RodionSmilovskyi/drone-control-center/printed_parts/TOF400C .jpg

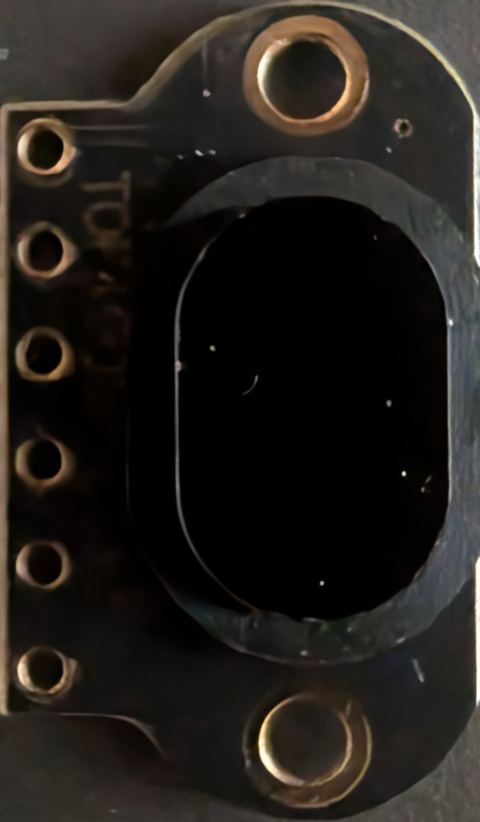
printed_parts/TOF400C .jpg
