RodionSmilovskyi/drone-control-center/printed_parts/PMW3901.jpg

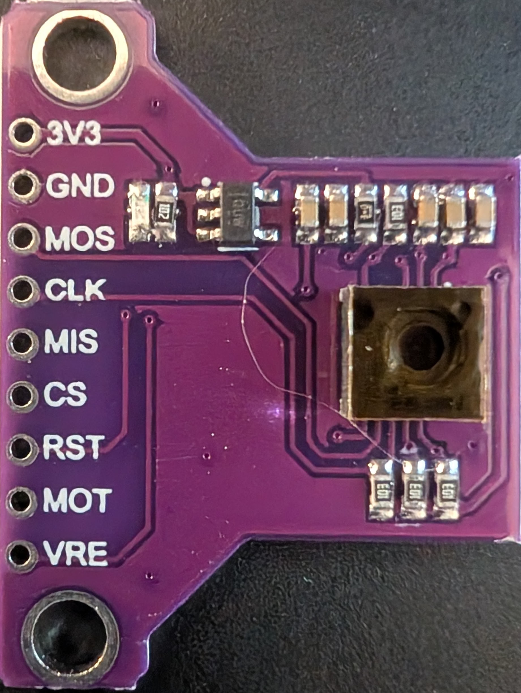
printed_parts/PMW3901.jpg
