RodionSmilovskyi/drone-control-center/README.md

# Useful commands
ssh rodion@10.0.0.131  
scp server.py  rodion@10.0.0.131:~/drone  

# Sample GUI output
Press 'q' to quit, 'r' to reboot, 'm' to change mode, 'a' to arm, 'd' to disarm and arrow keys to control  

ARMED: False                                      armingDisableFlags: []
cpuload: 23                                       cycleTime: 248
mode: 0                                           Flight Mode: []
Battery Voltage: 16.02V VOLTAGE TOO HIGH
Motor Values: [1000, 1000, 1000, 1000, 0, 0, 0, 0]
Attitude: [-1.3, -1.3, 73]
Altitude: 3.04
RC Channels Values: [1500, 1500, 1500, 900, 1000, 1000, 1500, 1500, 1500, 1500, 1500, 1500, 1500, 1500, 1500, 1500, 1500GUI cycleTime: 15.99ms (average 62.54Hz)]

apiVersion: 1.46.0                                flightControllerIdentifier: BTFL
flightControllerVersion: 4.5.2                    boardIdentifier: S405
boardName: SPEEDYBEEF405MINI                      name:
