RodionSmilovskyi/drone-control-center/requirements-pi.txt

#
# This file is autogenerated by pip-compile with Python 3.11
# by the following command:
#
#    pip-compile --extra=pi --output-file=requirements-pi.txt
#
adafruit-blinka==8.67.0
    # via
    #   adafruit-circuitpython-busdevice
    #   adafruit-circuitpython-connectionmanager
    #   adafruit-circuitpython-requests
    #   adafruit-circuitpython-typing
    #   adafruit-circuitpython-vl53l1x
    #   drone-control-center (pyproject.toml)
adafruit-circuitpython-busdevice==5.2.16
    # via
    #   adafruit-circuitpython-typing
    #   adafruit-circuitpython-vl53l1x
adafruit-circuitpython-connectionmanager==3.1.7
    # via adafruit-circuitpython-requests
adafruit-circuitpython-requests==4.1.16
    # via adafruit-circuitpython-typing
adafruit-circuitpython-typing==1.12.3
    # via
    #   adafruit-blinka
    #   adafruit-circuitpython-busdevice
adafruit-circuitpython-vl53l1x==1.2.7
    # via drone-control-center (pyproject.toml)
adafruit-platformdetect==3.88.0
    # via adafruit-blinka
adafruit-pureio==1.1.11
    # via adafruit-blinka
binho-host-adapter==0.1.6
    # via adafruit-blinka
gpiod==2.4.2
    # via
    #   drone-control-center (pyproject.toml)
    #   gpiodevice
gpiodevice==0.0.5
    # via drone-control-center (pyproject.toml)
markdown-it-py==4.0.0
    # via rich
mdurl==0.1.2
    # via markdown-it-py
numpy==1.23.5
    # via
    #   drone-control-center (pyproject.toml)
    #   tflite-runtime
pmw3901==1.0.0
    # via drone-control-center (pyproject.toml)
pyftdi==0.57.1
    # via adafruit-blinka
pygments==2.20.0
    # via rich
pyserial==3.5
    # via
    #   binho-host-adapter
    #   drone-control-center (pyproject.toml)
    #   pyftdi
    #   yamspy
pyusb==1.3.1
    # via pyftdi
pyzmq==27.1.0
    # via drone-control-center (pyproject.toml)
rich==15.0.0
    # via drone-control-center (pyproject.toml)
spidev==3.8
    # via
    #   drone-control-center (pyproject.toml)
    #   pmw3901
sysv-ipc==1.2.0
    # via adafruit-blinka
tflite-runtime==2.14.0
    # via drone-control-center (pyproject.toml)
typing-extensions==4.15.0
    # via adafruit-circuitpython-typing
yamspy==0.3.3
    # via drone-control-center (pyproject.toml)
