RodionSmilovskyi/drone-control-center/docs/data_injection_pipeline.png

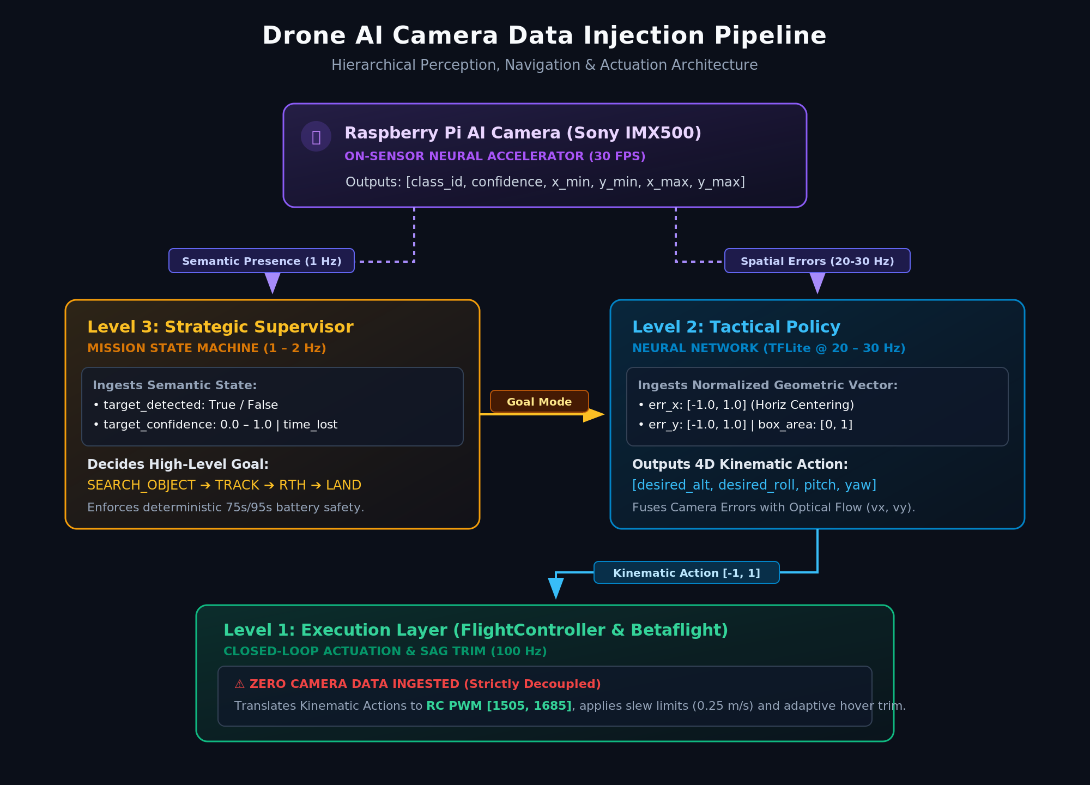
docs/data_injection_pipeline.png
