RodionSmilovskyi/drone-control-center/printed_parts/assembly-BottomStand3.stl

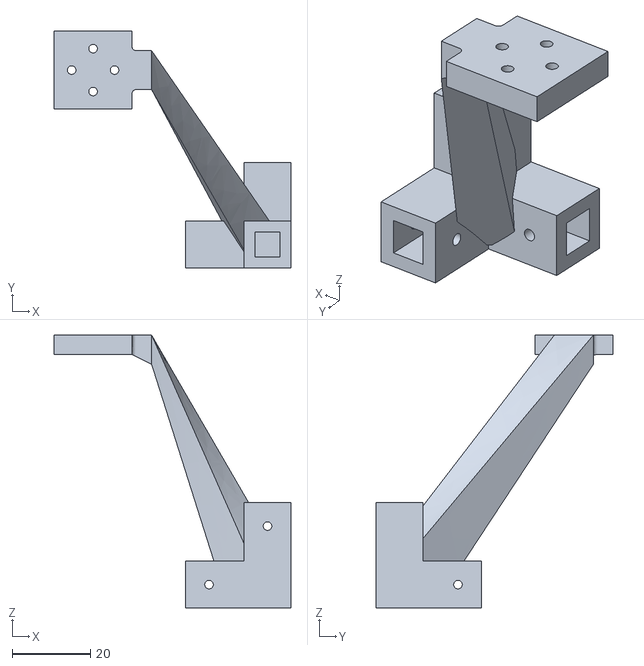
[picture p4: CAD file, 2026-09-27]
printed_parts/assembly-BottomStand3.stl
60.7 x 60.7 x 70.0
