RodionSmilovskyi/drone-control-center/printed_parts/assembly.FCStd

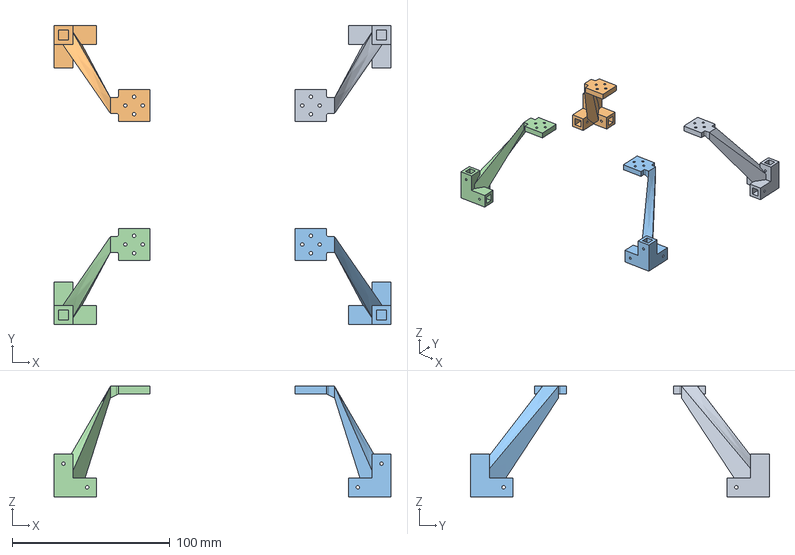
[picture p5: CAD file, 2026-09-27]
printed_parts/assembly.FCStd
213.4 x 189.4 x 70.0 mm
FrontBottomLeftStand
BottomStand (Mirror #1)
BottomStand (Mirror #3)
BottomStand (Mirror #5)
