RodionSmilovskyi/drone-control-center/printed_parts/assembly-HorizontaRod_short.stl

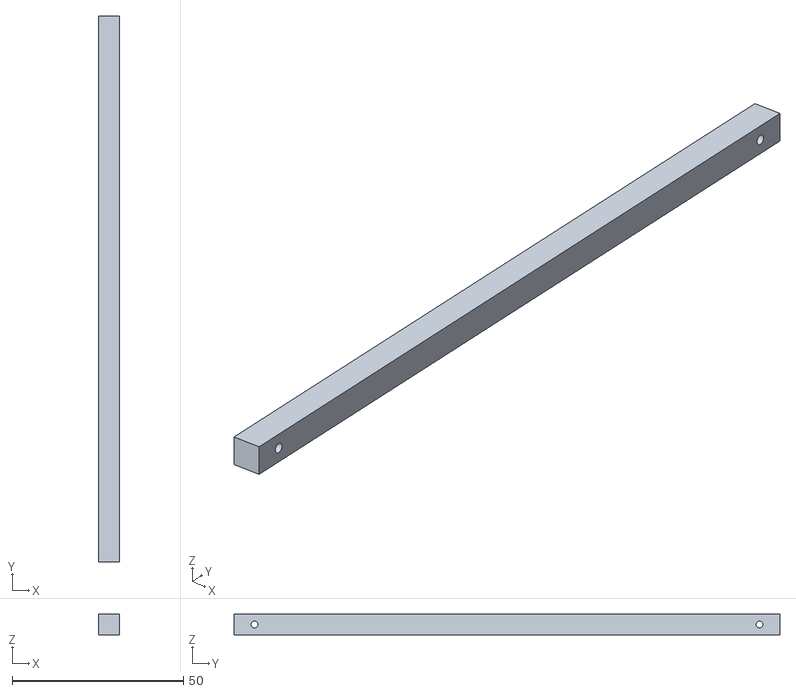
[picture p6: CAD file, 2026-02-09]
printed_parts/assembly-HorizontaRod_short.stl
6.00 x 159.4 x 6.00
