RodionSmilovskyi/drone-control-center/printed_parts/assembly-HorizontalRod_long.stl

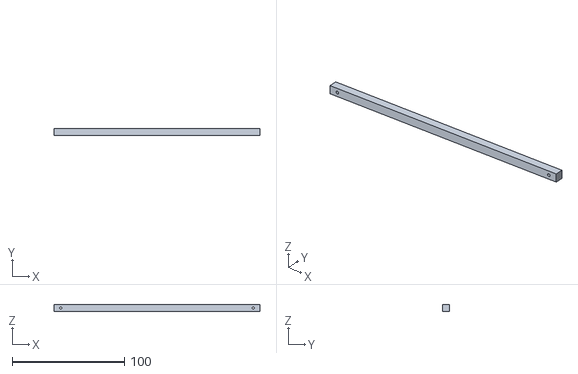
[picture p7: CAD file, 2026-02-09]
printed_parts/assembly-HorizontalRod_long.stl
183.4 x 6.00 x 6.00
