RodionSmilovskyi/drone-control-center/printed_parts/assembly-TopStand.stl

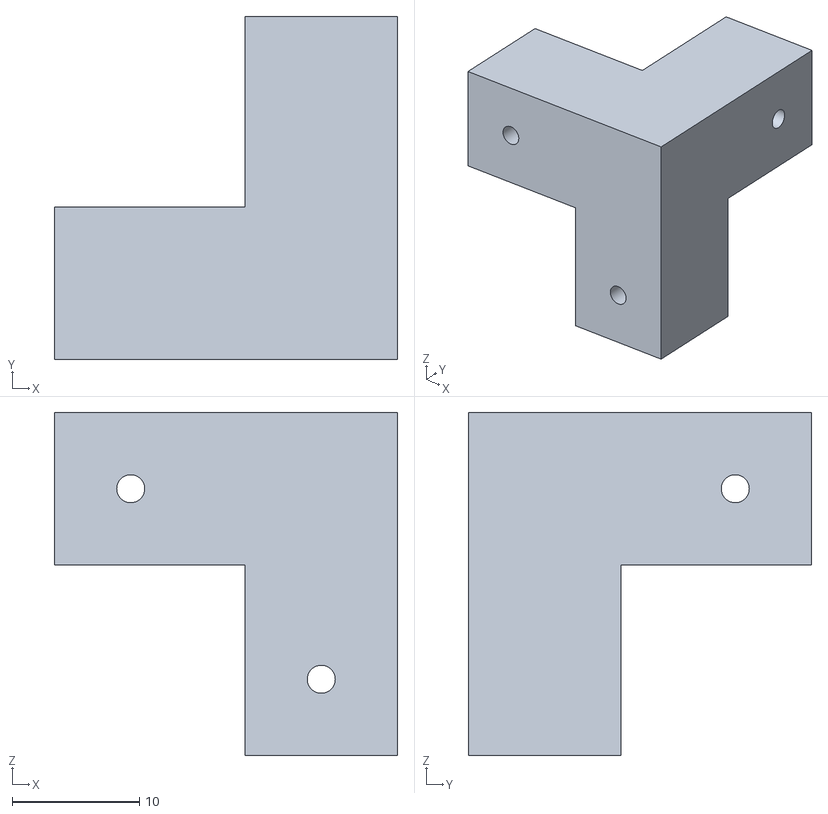
[picture p8: CAD file, 2026-02-08]
printed_parts/assembly-TopStand.stl
27.0 x 27.0 x 27.0
