RodionSmilovskyi/drone-control-center/printed_parts/assembly-VerticalRod.stl

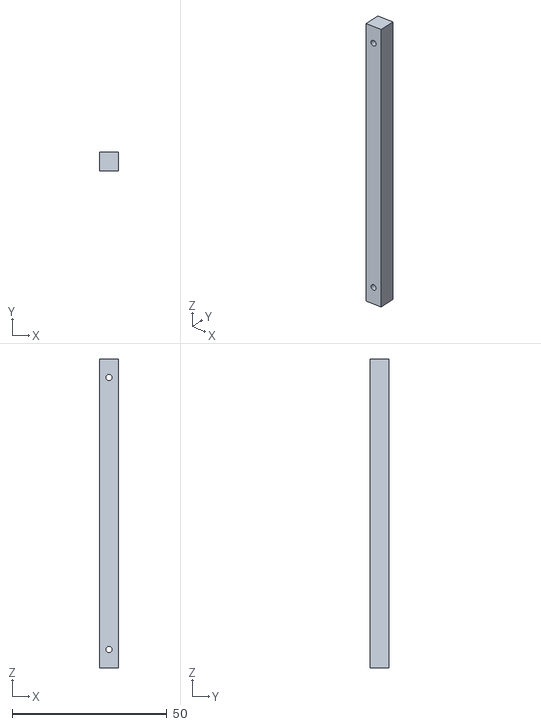
[picture p9: CAD file, 2026-02-08]
printed_parts/assembly-VerticalRod.stl
6.00 x 6.00 x 100.0
