RodionSmilovskyi/drone-control-center/printed_parts/2_Pin.STL

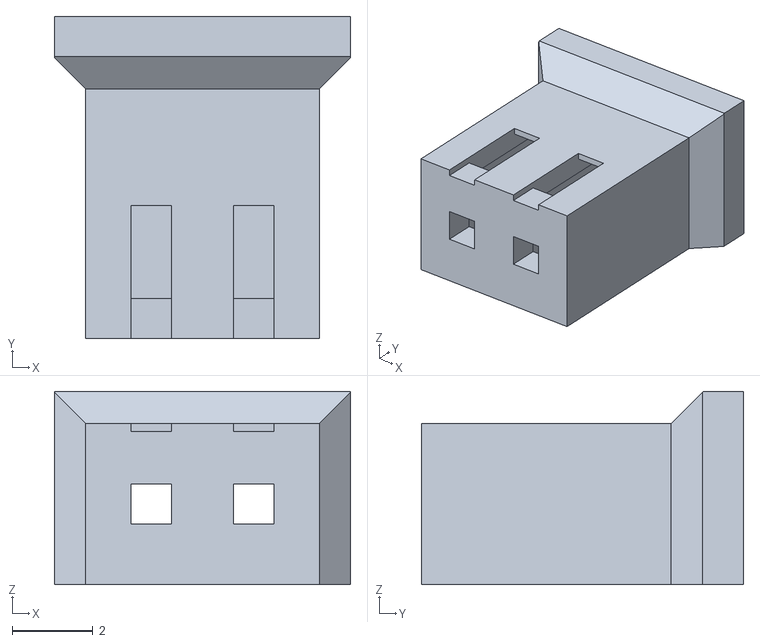
[picture p10: CAD file, 2026-09-27]
printed_parts/2_Pin.STL
7.35 x 8.00 x 4.80
