RodionSmilovskyi/drone-control-center/printed_parts/enclosure.FCStd

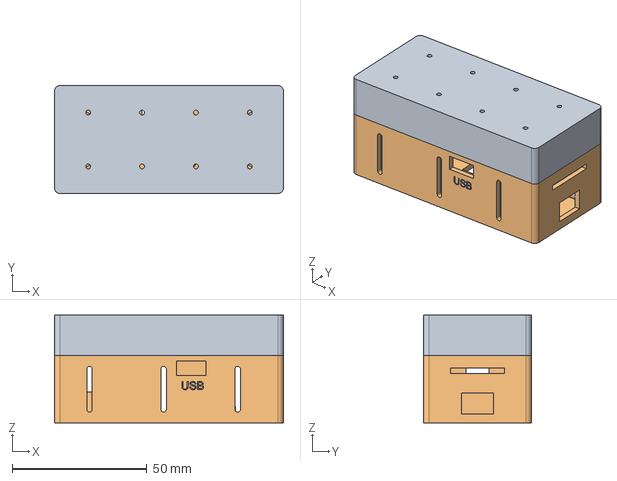
[picture p11: CAD file, 2026-09-27]
printed_parts/enclosure.FCStd
85.0 x 40.0 x 40.0 mm
top lid
bottom lid
