RodionSmilovskyi/drone-control-center/printed_parts/xh-2y.FCStd

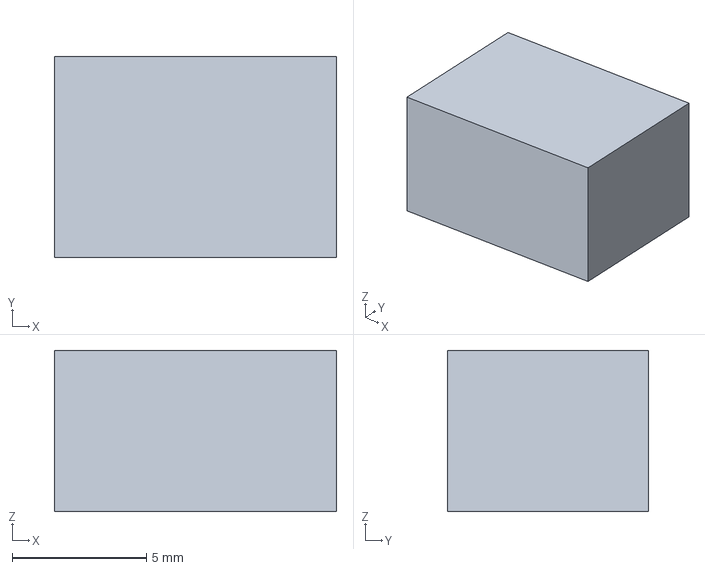
[picture p12: CAD file, 2026-09-27]
printed_parts/xh-2y.FCStd
10.5 x 7.50 x 6.00 mm
