RodionSmilovskyi/drone-control-center/printed_parts/Raspberry Pi Zero 2 W with Textures.stp

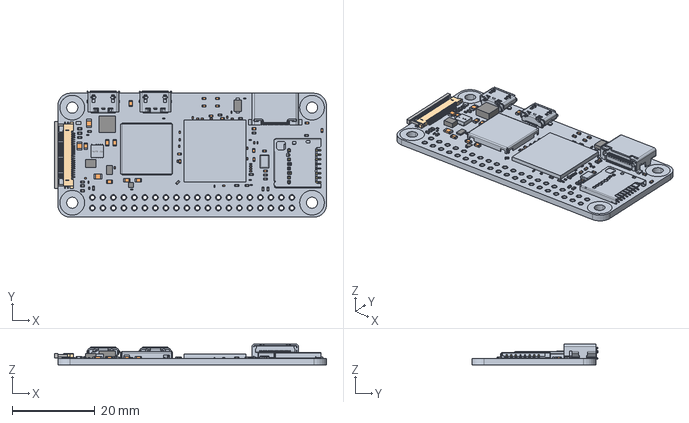
[picture p13: CAD file, 2026-09-27]
printed_parts/Raspberry Pi Zero 2 W with Textures.stp
65.8 x 30.6 x 5.05 mm
