RodionSmilovskyi/drone-control-center/printed_parts/TOF400C.FCStd

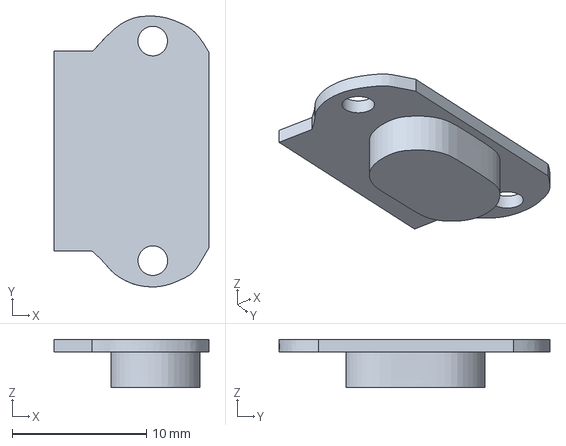
[picture p14: CAD file, 2026-09-27]
printed_parts/TOF400C.FCStd
11.5 x 20.1 x 3.58 mm
