RodionSmilovskyi/drone-control-center/printed_parts/PMW3901.FCStd

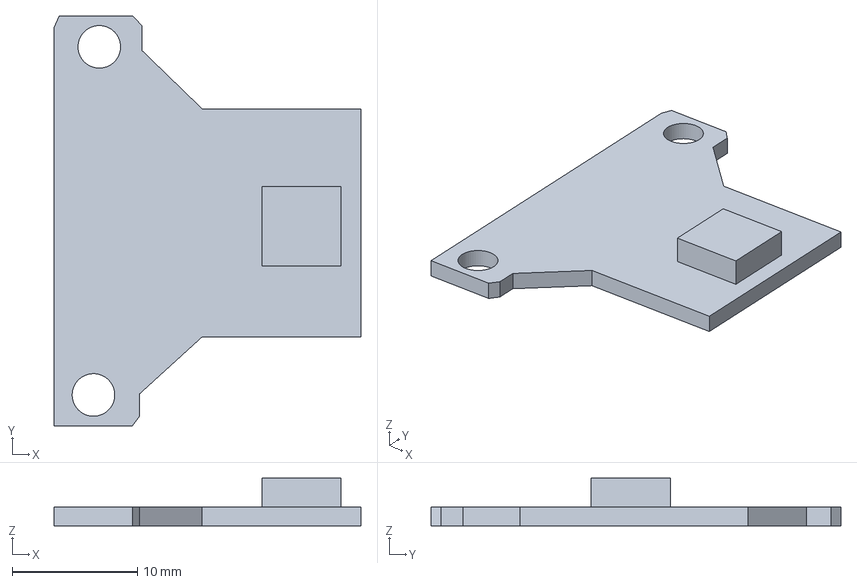
[picture p15: CAD file, 2026-09-27]
printed_parts/PMW3901.FCStd
24.5 x 32.8 x 3.80 mm
