RodionSmilovskyi/drone-control-center/printed_parts/enclosure-top lid.stl

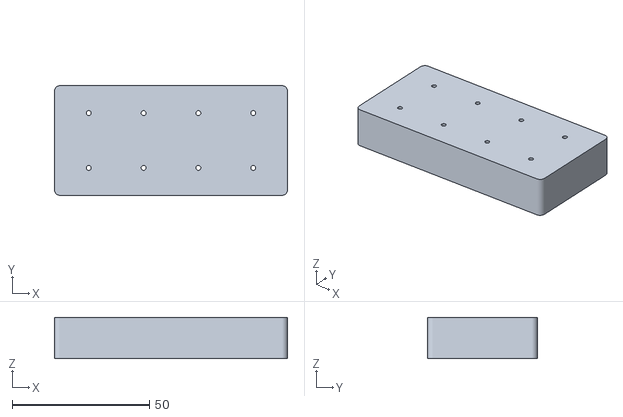
[picture p16: CAD file, 2026-09-27]
printed_parts/enclosure-top lid.stl
85.0 x 40.0 x 15.0
