RodionSmilovskyi/drone-control-center/printed_parts/raspberry-pi.FCStd

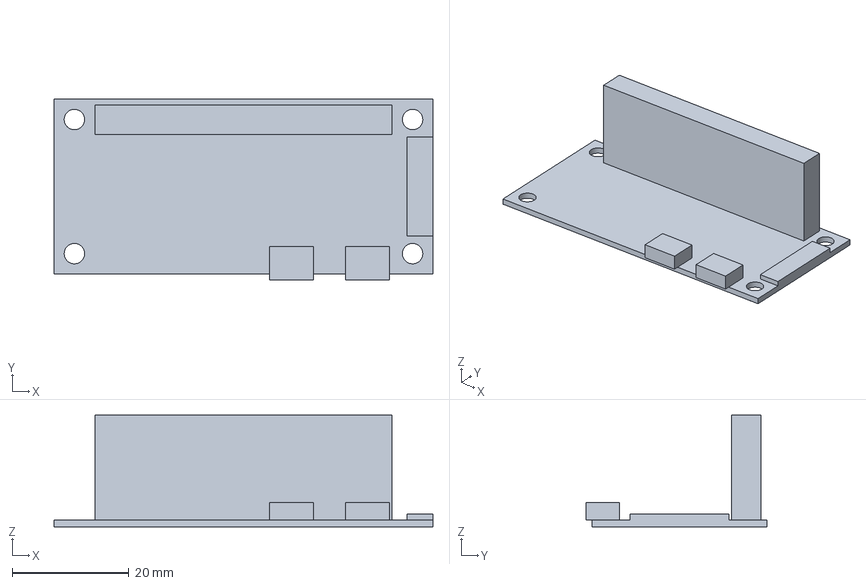
[picture p17: CAD file, 2026-09-27]
printed_parts/raspberry-pi.FCStd
65.0 x 31.0 x 19.2 mm
