RodionSmilovskyi/drone-control-center/printed_parts/raspberry-pi-PartBody.dxf

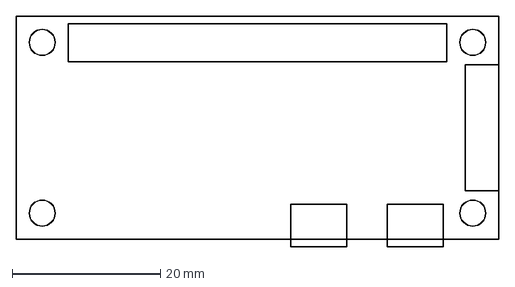
[picture p18: CAD file, 2026-09-27]
printed_parts/raspberry-pi-PartBody.dxf
65.0 x 31.0 mm
