RodionSmilovskyi/drone-control-center/printed_parts/enclosure-bottom lid.stl

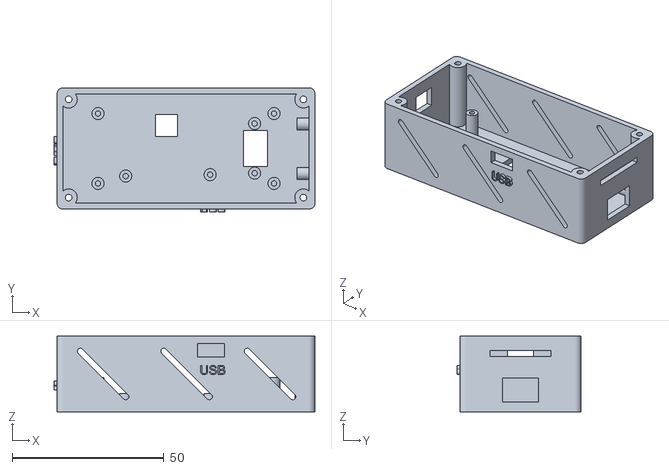
[picture p19: CAD file, 2026-09-27]
printed_parts/enclosure-bottom lid.stl
86.0 x 41.0 x 25.0
