RodionSmilovskyi/drone-control-center/printed_parts/front-sensor-holder.stl

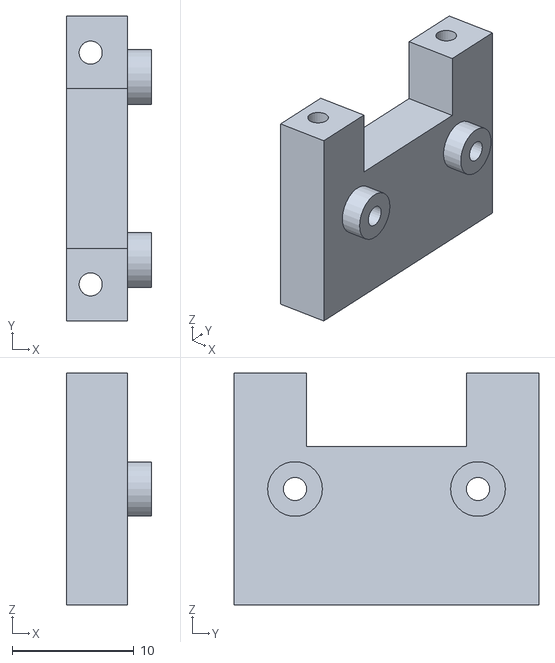
[picture p20: CAD file, 2026-02-08]
printed_parts/front-sensor-holder.stl
7.00 x 25.0 x 19.0
