RodionSmilovskyi/drone-control-center/printed_parts/bottom-sensor-holder.stl

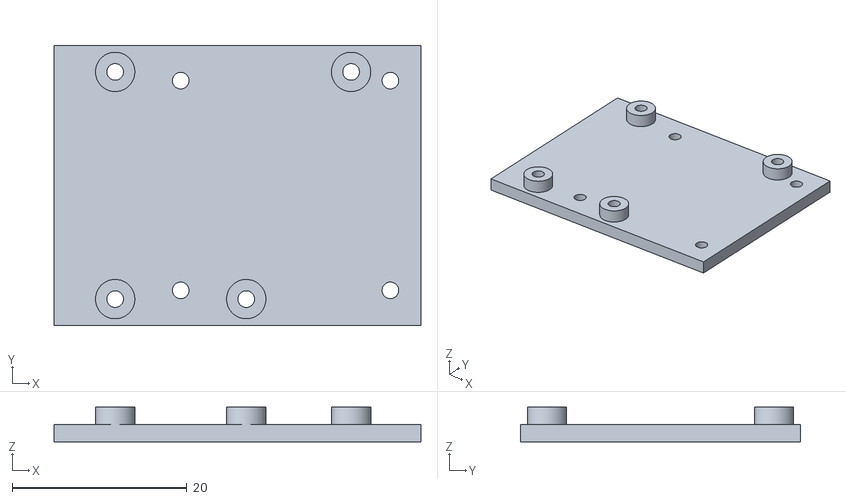
[picture p21: CAD file, 2026-02-08]
printed_parts/bottom-sensor-holder.stl
42.0 x 32.0 x 4.00
