RodionSmilovskyi/drone-control-center/(list of files, cad)

Other CAD files:
printed_parts/assembly-BottomStand2.stl
printed_parts/assembly-BottomStand4.stl
printed_parts/assembly-BottomStand1.stl
printed_parts/ai-case.FCStd
printed_parts/raspberry pi.stl
