RodionSmilovskyi/drone-control-center/custom_pcbs/breakout_board/breakout_board.kicad_pcb

## KiCad design custom_pcbs/breakout_board/breakout_board.kicad_pcb (2026-09-27)

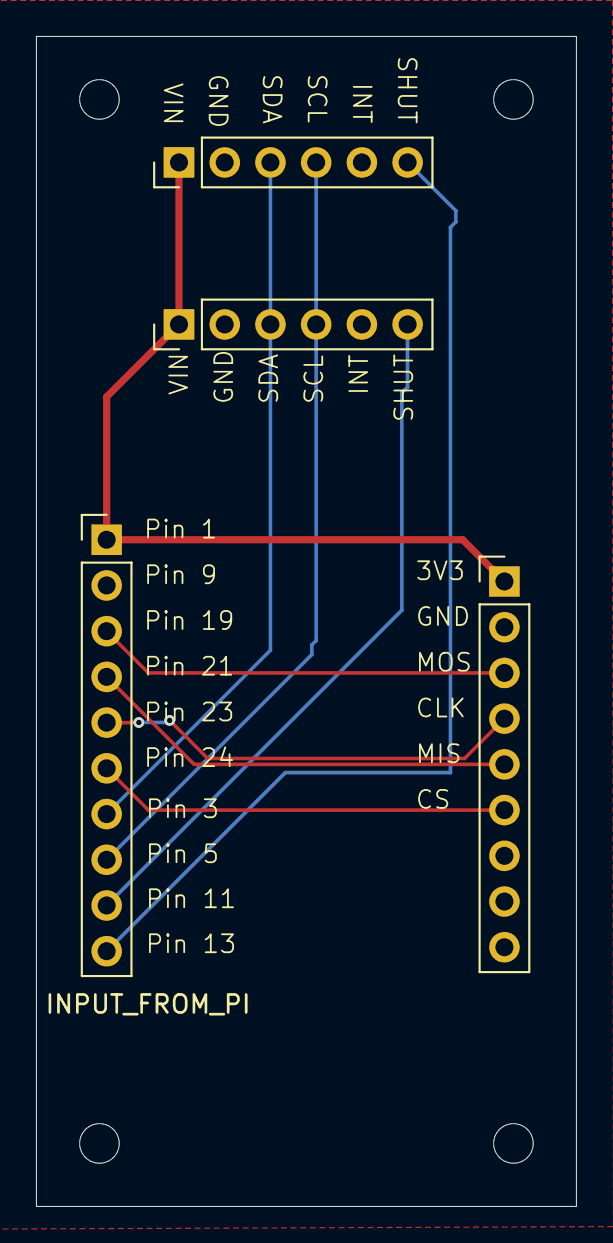
[picture p22: board breakout_board.kicad_pcb from above]

Board: 4 copper layers, 30.0 x 65.0 mm, 8 parts (0 on the bottom side), 10 nets.

Parts:
H1, H2, H3, H4: MountingHole; MountingHole_2.2mm_M2
J1: INPUT_FROM_PI; PinHeader_1x10_P2.54mm_Vertical
J2: PMW3901_OUT; PinHeader_1x09_P2.54mm_Vertical
VL53L1X_1_OUT, VL53L1X_2_OUT: Conn_01x06; PinHeader_1x06_P2.54mm_Vertical

Connections:
+3V3: J1.1, J2.1, VL53L1X_1_OUT.1, VL53L1X_2_OUT.1
/I2C_SCL: J1.8, VL53L1X_1_OUT.4, VL53L1X_2_OUT.4
/I2C_SDA: J1.7, VL53L1X_1_OUT.3, VL53L1X_2_OUT.3
/SPI_CLK: J1.5, J2.4
/SPI_CS: J1.6, J2.6
/SPI_MISO: J1.4, J2.5
/SPI_MOSI: J1.3, J2.3
/XSHUT_1: J1.9, VL53L1X_1_OUT.6
/XSHUT_2: J1.10, VL53L1X_2_OUT.6
GND: J1.2, J2.2, VL53L1X_1_OUT.2, VL53L1X_2_OUT.2
