RodionSmilovskyi/drone-control-center/services/drone-sensors/sensor_real.py

import time
import board
import digitalio
import adafruit_vl53l1x
import pmw3901
import logging
import sys
import os
import threading
import math

# Add project root to sys.path
sys.path.insert(0, os.path.abspath(os.path.join(os.path.dirname(__file__), '../..')))
from core.drone_logging import setup_logger

MAX_XY_SHIFT = 1.0

# --- Configuration ---
LOG_FILE = "sensor.log"

# --- Pin Definitions ---
DOWN_SENSOR_SHUT_PIN = board.D17
OBSTACLE_SENSOR_SHUT_PIN = board.D27
DOWN_SENSOR_ADDRESS = 0x30
FRONT_SENSOR_ADDRESS = 0x31
SPI_CS_PIN = 8 

class SensorReal:
    def __init__(self):
        self.logger = setup_logger("Sensor_Real", LOG_FILE, logging.INFO)
        self.sensor_down = None
        self.sensor_front = None
        self.flow = None
        
        # State variables
        self.altitude = 0.0
        self.front_dist = 0.0
        self.shift_x = 0.0
        self.shift_y = 0.0
        self.vel_x_norm = 0.0
        self.vel_y_norm = 0.0
        self.last_time = time.time()

        # Optical Flow Constants (PMW3901)
        self.FOV_DEGREES = 42.0
        self.RESOLUTION = 35.0
        # Calibrated value: 20cm move at ~13.7cm altitude resulted in 731 pixels.
        # Constant = 0.20 / (731 * 0.137) ≈ 0.001997
        self.FLOW_METERS_PER_PIXEL_PER_METER = 0.001997
        
        # Normalization and Calibration
        self.MAX_VELOCITY = 5.0
        self.MAX_XY_SHIFT = MAX_XY_SHIFT # From strategic_agent
        self.MAX_ALTITUDE = 3.0
        self.MAX_FRONT_DISTANCE = 3.0
        self.NOMINAL_FLOW_DT = 0.035      # Nominal ~28.5 Hz PMW3901 frame interval for multi-frame stall normalization
        self.MAX_FRAME_SHIFT_M = 0.030    # Max 3.0 cm single-frame displacement step to reject SPI/rotational spikes
        self.MAX_PHYSICAL_VEL_MS = 0.60   # Max 0.60 m/s physical indoor speed clamp before normalization
        
        # Deadbands and Smoothing
        self.FLOW_DEADBAND = 0.05 # Threshold on filtered value to suppress jitter
        self.ALPHA_FLOW = 0.42   # Balanced optical flow LPF (~45ms tau) to suppress SPI pixel steps while keeping low lag
        self.ALPHA_ALT = 0.6     # Lower phase lag for altitude feedback
        self.ALPHA_FRONT = 0.3
        self.ALPHA_VEL = 0.45    # Balanced velocity LPF (~40ms tau) to prevent single-frame D-term kicks in inner loop
        self.GROUND_ALT_THRESHOLD = 0.045  # Above resting/spin-up ground height (~0.028-0.043m)

        self.filtered_dx = 0.0
        self.filtered_dy = 0.0

        self.lock = threading.Lock()
        self._init_hardware()
        
        # Start dedicated background polling threads for I2C (ToF) and SPI (Optical Flow)
        # so that blocking SPI motion waits never stall altitude ToF updates, and SPI burst
        # reads are never prematurely aborted before frame completion.
        self.stop_thread = False
        self.tof_thread = threading.Thread(target=self._poll_tof_loop, daemon=True)
        self.flow_thread = threading.Thread(target=self._poll_flow_loop, daemon=True)
        self.tof_thread.start()
        self.flow_thread.start()

    def _init_hardware(self):
        try:
            i2c = board.I2C()
            xshut_down = digitalio.DigitalInOut(DOWN_SENSOR_SHUT_PIN)
            xshut_down.direction = digitalio.Direction.OUTPUT

            xshut_front = digitalio.DigitalInOut(OBSTACLE_SENSOR_SHUT_PIN)
            xshut_front.direction = digitalio.Direction.OUTPUT
            
            # Shut down both sensors
            xshut_down.value = False
            xshut_front.value = False
            time.sleep(0.1)
            
            # Initialize Down Sensor
            try:
                xshut_down.value = True
                time.sleep(0.1)
                self.sensor_down = adafruit_vl53l1x.VL53L1X(i2c)
                self.sensor_down.set_address(DOWN_SENSOR_ADDRESS)
                self.sensor_down.start_ranging()
                self.logger.info("Down-Sensor initialized.")
            except Exception as e:
                self.logger.error(f"Failed to init Down-Sensor: {e}")

            # Initialize Front Sensor
            try:
                xshut_front.value = True
                time.sleep(0.1)
                self.sensor_front = adafruit_vl53l1x.VL53L1X(i2c)
                self.sensor_front.set_address(FRONT_SENSOR_ADDRESS)
                self.sensor_front.start_ranging()
                self.logger.info("Front-Sensor initialized.")
            except Exception as e:
                self.logger.error(f"Failed to init Front-Sensor: {e}")

            # Initialize Optical Flow
            try:
                self.flow = pmw3901.PMW3901(spi_cs_gpio=SPI_CS_PIN)
                self.flow.set_rotation(0)
                self.logger.info("Optical Flow initialized.")
            except Exception as e:
                self.logger.error(f"Failed to init Optical Flow: {e}")

        except Exception as e:
            self.logger.critical(f"Hardware Initialization Error: {e}")

    def _poll_tof_loop(self):
        """Dedicated I2C polling loop for downward (altitude) and forward ToF sensors."""
        while not self.stop_thread:
            with self.lock:
                new_alt = self.altitude
                new_front = self.front_dist

            # 1. Altitude Reading
            if self.sensor_down:
                try:
                    if self.sensor_down.data_ready:
                        raw_dist = self.sensor_down.distance 
                        if raw_dist is not None:
                            raw_alt_m = max(0.0, min(self.MAX_ALTITUDE, raw_dist / 100.0))
                            new_alt = (self.ALPHA_ALT * raw_alt_m) + ((1.0 - self.ALPHA_ALT) * new_alt)
                        self.sensor_down.clear_interrupt()
                except Exception:
                    pass

            # 2. Front Distance Reading
            if self.sensor_front:
                try:
                    if self.sensor_front.data_ready:
                        raw_front_dist = self.sensor_front.distance
                        if raw_front_dist is not None:
                            raw_front_m = max(0.0, min(self.MAX_FRONT_DISTANCE, raw_front_dist / 100.0))
                            new_front = (self.ALPHA_FRONT * raw_front_m) + ((1.0 - self.ALPHA_FRONT) * new_front)
                        self.sensor_front.clear_interrupt()
                except Exception:
                    pass

            with self.lock:
                self.altitude = new_alt
                self.front_dist = new_front
                if new_alt < self.GROUND_ALT_THRESHOLD:
                    self.shift_x = 0.0
                    self.shift_y = 0.0
                    self.vel_x_norm = 0.0
                    self.vel_y_norm = 0.0
                    self.filtered_dx = 0.0
                    self.filtered_dy = 0.0

            time.sleep(0.01)

    def _poll_flow_loop(self):
        """Dedicated SPI polling loop for PMW3901 optical flow displacement & velocity."""
        warmup_end = time.time() + 5.0

        while not self.stop_thread:
            if self.flow:
                try:
                    motion = self.flow.get_motion(timeout=0.025)
                    current_time = time.time()
                    if motion is not None:
                        dt = max(0.010, current_time - self.last_time)
                        self.last_time = current_time
                        if current_time > warmup_end:
                            dx, dy = motion
                            # If OS/SPI stalled across multiple frames (dt > 0.10s), normalize raw hardware-accumulated
                            # pixel counts to a nominal single-frame equivalent before the IIR filter so a stall burst
                            # does not contaminate self.filtered_dx on subsequent short-dt frames.
                            stall_scale = (self.NOMINAL_FLOW_DT / dt) if dt > 0.10 else 1.0
                            dx_frame = dx * stall_scale
                            dy_frame = dy * stall_scale

                            # 3a. Low Pass Filter per-frame motion
                            self.filtered_dx = (self.ALPHA_FLOW * dx_frame) + (1.0 - self.ALPHA_FLOW) * self.filtered_dx
                            self.filtered_dy = (self.ALPHA_FLOW * dy_frame) + (1.0 - self.ALPHA_FLOW) * self.filtered_dy

                            # 3b. Apply Deadbands to filtered motion
                            f_dx = self.filtered_dx if abs(self.filtered_dx) > self.FLOW_DEADBAND else 0.0
                            f_dy = self.filtered_dy if abs(self.filtered_dy) > self.FLOW_DEADBAND else 0.0

                            with self.lock:
                                cur_alt = self.altitude

                            integration_alt = max(0.02, cur_alt)

                            if integration_alt >= self.GROUND_ALT_THRESHOLD:
                                # distance in meters = counts * alt * (2*tan(FOV/2)/RES)
                                frame_step_x = max(-self.MAX_FRAME_SHIFT_M, min(self.MAX_FRAME_SHIFT_M, f_dx * integration_alt * self.FLOW_METERS_PER_PIXEL_PER_METER))
                                frame_step_y = max(-self.MAX_FRAME_SHIFT_M, min(self.MAX_FRAME_SHIFT_M, f_dy * integration_alt * self.FLOW_METERS_PER_PIXEL_PER_METER))
                                d_shift_x_m = frame_step_x / stall_scale if stall_scale < 1.0 else frame_step_x
                                d_shift_y_m = frame_step_y / stall_scale if stall_scale < 1.0 else frame_step_y
                                eff_dt = self.NOMINAL_FLOW_DT if stall_scale < 1.0 else dt

                                with self.lock:
                                    # Store in METERS
                                    self.shift_x += d_shift_x_m
                                    self.shift_y += d_shift_y_m

                                    # Hard Clamp shift in meters to [-MAX_XY_SHIFT, MAX_XY_SHIFT]
                                    self.shift_x = max(-self.MAX_XY_SHIFT, min(self.MAX_XY_SHIFT, self.shift_x))
                                    self.shift_y = max(-self.MAX_XY_SHIFT, min(self.MAX_XY_SHIFT, self.shift_y))

                                    if eff_dt > 0:
                                        # Clamp physical velocity to [-MAX_PHYSICAL_VEL_MS, MAX_PHYSICAL_VEL_MS] before normalizing
                                        vx_ms = max(-self.MAX_PHYSICAL_VEL_MS, min(self.MAX_PHYSICAL_VEL_MS, frame_step_x / eff_dt))
                                        vy_ms = max(-self.MAX_PHYSICAL_VEL_MS, min(self.MAX_PHYSICAL_VEL_MS, frame_step_y / eff_dt))
                                        raw_vx = max(-1.0, min(1.0, vx_ms / self.MAX_VELOCITY))
                                        raw_vy = max(-1.0, min(1.0, vy_ms / self.MAX_VELOCITY))
                                        self.vel_x_norm = (self.ALPHA_VEL * raw_vx) + ((1.0 - self.ALPHA_VEL) * self.vel_x_norm)
                                        self.vel_y_norm = (self.ALPHA_VEL * raw_vy) + ((1.0 - self.ALPHA_VEL) * self.vel_y_norm)
                            else:
                                with self.lock:
                                    self.vel_x_norm = 0.0
                                    self.vel_y_norm = 0.0
                                    self.filtered_dx = 0.0
                                    self.filtered_dy = 0.0
                                    if cur_alt < self.GROUND_ALT_THRESHOLD:
                                        self.shift_x = 0.0
                                        self.shift_y = 0.0
                    time.sleep(0.01)
                except (RuntimeError, Exception):
                    self.last_time = time.time()
                    with self.lock:
                        self.vel_x_norm *= (1.0 - self.ALPHA_VEL)
                        self.vel_y_norm *= (1.0 - self.ALPHA_VEL)
                        self.filtered_dx = 0.0
                        self.filtered_dy = 0.0
            else:
                time.sleep(0.01)

    def reset_shifts(self):
        with self.lock:
            self.shift_x = 0.0
            self.shift_y = 0.0

    def read(self):
        with self.lock:
            # Longitudinal axis (Y) is inverted on PMW3901 hardware mount; negate shift_x and vel_x
            # so that forward drone movement produces positive Y displacement and velocity.
            return [self.altitude, self.front_dist, self.shift_y, -self.shift_x, self.vel_y_norm, -self.vel_x_norm]
