RodionSmilovskyi/drone-control-center/scripts/simpleUI.py

"""simpleUI.py: Simple UI (toy one really) to test YAMSPy using a SSH connection.

Copyright (C) 2020 Ricardo de Azambuja

This file is part of YAMSPy.

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

WARNING:
This UI is not fit for flying your drone, it is only useful for testing stuff in a safe place, ok?

Acknowledgement:
This work was possible thanks to the financial support from IVADO.ca (postdoctoral scholarship 2019/2020).

Disclaimer (adapted from Wikipedia):
None of the authors, contributors, supervisors, administrators, employers, friends, family, vandals, or anyone else 
connected (or not) with this project, in any way whatsoever, can be made responsible for your use of the information (code) 
contained or linked from here.


TODO:
1) The integrator makes it too hard to control things (it winds up). Probably a non-linear thing would be helpful here...
2) Everything is far from optimal so it could be improved... but it's a simpleUI example after all ;)
"""

__author__ = "Ricardo de Azambuja"
__copyright__ = "Copyright 2020, MISTLab.ca"
__credits__ = [""]
__license__ = "GPL"
__version__ = "0.0.1"
__maintainer__ = "Ricardo de Azambuja"
__email__ = "ricardo.azambuja@gmail.com"
__status__ = "Development"

import time
import curses
import logging
from collections import deque
from itertools import cycle
import numpy as np
import tflite_runtime.interpreter as tflite

from yamspy import MSPy

# --- Logging setup: reset log file on every start ---
LOG_FILE = "simpleUI.log"

_ui_logger = logging.getLogger('simpleUI')
_ui_logger.setLevel(logging.INFO)
_ui_logger.propagate = False  # do NOT bubble up to root (blocks MSPy spam)

_log_handler = logging.FileHandler(LOG_FILE, mode='w')  # 'w' resets on each run
_log_handler.setFormatter(logging.Formatter('%(asctime)s  %(message)s', datefmt='%H:%M:%S'))
_ui_logger.addHandler(_log_handler)

# Silence MSPy's own logger so its serial debug bytes never reach our file
logging.getLogger('MSPy').setLevel(logging.WARNING)


def log_addstr(screen, row, col, text, *args):
    """Wrapper around screen.addstr that also logs the text to file."""
    screen.addstr(row, col, text, *args)
    _ui_logger.info("[row=%d col=%d] %s", row, col, text)

# Max periods for:
CTRL_LOOP_TIME = 1/100
SLOW_MSGS_LOOP_TIME = 1/5 # these messages take a lot of time slowing down the loop...

NO_OF_CYCLES_AVERAGE_GUI_TIME = 10
AI_COMMAND = None # [thrttole, roll, pitch, yaw]
AI_MODE = False
MAX_ALT = 1
TAGET_ALT = 0.05
MAX_ROLL_PITCH = 55
MAX_YAW = 360

#
# On Linux, your serial port will probably be something like
# /dev/ttyACM0 or /dev/ttyS0 or the same names with numbers different from 0
#
# On Windows, I would expect it to be 
# COM1 or COM2 or COM3...
#
# This library uses pyserial, so if you have more questions try to check its docs:
# https://pyserial.readthedocs.io/en/latest/shortintro.html
#
#
SERIAL_PORT = "/dev/ttyACM0"

PROJECT_ROOT = os.path.dirname(os.path.dirname(os.path.abspath(__file__)))
MODEL_PATH = os.path.join(PROJECT_ROOT, "models", "master-model.tflite")

interpreter = tflite.Interpreter(model_path=MODEL_PATH)
interpreter.allocate_tensors()
input_details = interpreter.get_input_details()
output_details = interpreter.get_output_details()

def run_curses(external_function):
    result=1

    try:
        # get the curses screen window
        screen = curses.initscr()

        # turn off input echoing
        curses.noecho()

        # respond to keys immediately (don't wait for enter)
        curses.cbreak()

        # non-blocking
        screen.timeout(0)

        # map arrow keys to special values
        screen.keypad(True)

        log_addstr(screen, 1, 0, "Press 'q' to quit, 'r' to reboot, 'm' to change mode, 'a' to arm, 'd' to disarm and arrow keys to control", curses.A_BOLD)
        
        result = external_function(screen)

    finally:
        # shut down cleanly
        curses.nocbreak(); screen.keypad(0); curses.echo()
        curses.endwin()
        if result==1:
            print("An error occurred... probably the serial port is not available ;)")

def keyboard_controller(screen):

    CMDS = {
            'roll':     1500,
            'pitch':    1500,
            'throttle': 900,
            'yaw':      1500,
            'aux1':     1000,
            'aux2':     1000
            }

    # This order is the important bit: it will depend on how your flight controller is configured.
    # Below it is considering the flight controller is set to use AETR.
    # The names here don't really matter, they just need to match what is used for the CMDS dictionary.
    # In the documentation, iNAV uses CH5, CH6, etc while Betaflight goes AUX1, AUX2...
    CMDS_ORDER = ['roll', 'pitch', 'throttle', 'yaw', 'aux1', 'aux2']

    # "print" doesn't work with curses, use addstr instead
    try:
        log_addstr(screen, 15, 0, "Connecting to the FC...")

        with MSPy(device=SERIAL_PORT, loglevel='WARNING', baudrate=115200) as board:
            if board == 1: # an error occurred...
                return 1

            log_addstr(screen, 15, 0, "Connecting to the FC... connected!")
            screen.clrtoeol()
            screen.move(1,0)

            average_cycle = deque([0]*NO_OF_CYCLES_AVERAGE_GUI_TIME)

            # It's necessary to send some messages or the RX failsafe will be activated
            # and it will not be possible to arm.
            command_list = ['MSP_API_VERSION', 'MSP_FC_VARIANT', 'MSP_FC_VERSION', 'MSP_BUILD_INFO', 
                            'MSP_BOARD_INFO', 'MSP_UID', 'MSP_ACC_TRIM', 'MSP_NAME', 'MSP_STATUS', 'MSP_STATUS_EX',
                            'MSP_BATTERY_CONFIG', 'MSP_BATTERY_STATE', 'MSP_BOXNAMES', 'MSP_ATTITUDE', 'MSP_ALTITUDE']

            if board.INAV:
                command_list.append('MSPV2_INAV_ANALOG')
                command_list.append('MSP_VOLTAGE_METER_CONFIG')

            for msg in command_list: 
                if board.send_RAW_msg(MSPy.MSPCodes[msg], data=[]):
                    dataHandler = board.receive_msg()
                    board.process_recv_data(dataHandler)
            if board.INAV:
                cellCount = board.BATTERY_STATE['cellCount']
            else:
                cellCount = 0 # MSPV2_INAV_ANALOG is necessary
            min_voltage = board.BATTERY_CONFIG['vbatmincellvoltage']*cellCount
            warn_voltage = board.BATTERY_CONFIG['vbatwarningcellvoltage']*cellCount
            max_voltage = board.BATTERY_CONFIG['vbatmaxcellvoltage']*cellCount

            log_addstr(screen, 15, 0, "apiVersion: {}".format(board.CONFIG['apiVersion']))
            screen.clrtoeol()
            log_addstr(screen, 15, 50, "flightControllerIdentifier: {}".format(board.CONFIG['flightControllerIdentifier']))
            log_addstr(screen, 16, 0, "flightControllerVersion: {}".format(board.CONFIG['flightControllerVersion']))
            log_addstr(screen, 16, 50, "boardIdentifier: {}".format(board.CONFIG['boardIdentifier']))
            log_addstr(screen, 17, 0, "boardName: {}".format(board.CONFIG['boardName']))
            log_addstr(screen, 17, 50, "name: {}".format(board.CONFIG['name']))


            slow_msgs = cycle(['MSP_ANALOG', 'MSP_STATUS_EX', 'MSP_MOTOR', 'MSP_RC', 'MSP_ATTITUDE', 'MSP_ALTITUDE'])

            cursor_msg = ""
            last_loop_time = last_slow_msg_time = last_cycleTime = time.time()
            while True:
                start_time = time.time()

                char = screen.getch() # get keypress
                curses.flushinp() # flushes buffer
                

                #
                # Key input processing
                #

                #
                # KEYS (NO DELAYS)
                #
                if char == ord('q') or char == ord('Q'):
                    break

                elif char == ord('d') or char == ord('D'):
                    cursor_msg = 'Sending Disarm command...'
                    CMDS['aux1'] = 1000

                elif char == ord('r') or char == ord('R'):
                    log_addstr(screen, 3, 0, 'Sending Reboot command...')
                    screen.clrtoeol()
                    board.reboot()
                    time.sleep(0.5)
                    break
                
                elif char == ord('c') or char == ord('C'):
                    cursor_msg = 'Calibration and AI mode ON'
                    AI_MODE = True
                    if board.send_RAW_msg(MSPy.MSPCodes['MSP_ACC_CALIBRATION'], data=[]):
                        dataHandler = board.receive_msg()
                        board.process_recv_data(dataHandler)
                        
                elif char == ord('u') or char == ord('U'):
                    cursor_msg = 'Target alt set to 0.5'
                    TAGET_ALT = 0.5
                    
                elif char == ord('d') or char == ord('d'):
                    cursor_msg = 'Target alt set to 0.1'
                    TAGET_ALT = 0.1
                        
                elif char == ord('o') or char == ord('O'):
                    cursor_msg = 'AI mode OFF'
                    AI_MODE = False

                elif char == ord('a') or char == ord('A'):
                    cursor_msg = 'Sending Arm command...'
                    CMDS['aux1'] = 1800

                #
                # The code below is expecting the drone to have the
                # modes set accordingly since everything is hardcoded.
                #
                elif char == ord('m') or char == ord('M'):
                    if CMDS['aux2'] <= 1300:
                        cursor_msg = 'Horizon Mode...'
                        CMDS['aux2'] = 1500
                    elif 1700 > CMDS['aux2'] > 1300:
                        cursor_msg = 'Flip Mode...'
                        CMDS['aux2'] = 2000
                    elif CMDS['aux2'] >= 1700:
                        cursor_msg = 'Angle Mode...'
                        CMDS['aux2'] = 1000

                elif char == ord('w') or char == ord('W'):
                    CMDS['throttle'] = CMDS['throttle'] + 10 if CMDS['throttle'] + 10 <= 2000 else CMDS['throttle']
                    cursor_msg = 'W Key - throttle(+):{}'.format(CMDS['throttle'])

                elif char == ord('e') or char == ord('E'):
                    CMDS['throttle'] = CMDS['throttle'] - 10 if CMDS['throttle'] - 10 >= 1000 else CMDS['throttle']
                    cursor_msg = 'E Key - throttle(-):{}'.format(CMDS['throttle'])

                elif char == curses.KEY_RIGHT:
                    CMDS['roll'] = CMDS['roll'] + 10 if CMDS['roll'] + 10 <= 2000 else CMDS['roll']
                    cursor_msg = 'Right Key - roll(-):{}'.format(CMDS['roll'])

                elif char == curses.KEY_LEFT:
                    CMDS['roll'] = CMDS['roll'] - 10 if CMDS['roll'] - 10 >= 1000 else CMDS['roll']
                    cursor_msg = 'Left Key - roll(+):{}'.format(CMDS['roll'])

                elif char == curses.KEY_UP:
                    CMDS['pitch'] = CMDS['pitch'] + 10 if CMDS['pitch'] + 10 <= 2000 else CMDS['pitch']
                    cursor_msg = 'Up Key - pitch(+):{}'.format(CMDS['pitch'])

                elif char == curses.KEY_DOWN:
                    CMDS['pitch'] = CMDS['pitch'] - 10 if CMDS['pitch'] - 10 >= 1000 else CMDS['pitch']
                    cursor_msg = 'Down Key - pitch(-):{}'.format(CMDS['pitch'])

                #
                # IMPORTANT MESSAGES (CTRL_LOOP_TIME based)
                #
                if (time.time()-last_loop_time) >= CTRL_LOOP_TIME:
                    fast_dt = time.time()-last_loop_time
                    last_loop_time = time.time()
                    # Send the RC channel values to the FC
                    if board.send_RAW_RC([CMDS[ki] for ki in CMDS_ORDER]):
                        dataHandler = board.receive_msg()
                        board.process_recv_data(dataHandler)
                         

                #
                # SLOW MSG processing (user GUI)
                #
                if (time.time()-last_slow_msg_time) >= SLOW_MSGS_LOOP_TIME:
                    slow_dt = time.time()-last_slow_msg_time
                    last_slow_msg_time = time.time()
                    next_msg = next(slow_msgs) # circular list
                    
                    #plug ai
                    # AI_COMMAND = 

                    # Read info from the FC
                    if board.send_RAW_msg(MSPy.MSPCodes[next_msg], data=[]):
                        dataHandler = board.receive_msg()
                        board.process_recv_data(dataHandler)
                        
                    if next_msg == 'MSP_ANALOG':
                        voltage = board.ANALOG['voltage']
                        voltage_msg = ""
                        if min_voltage < voltage <= warn_voltage:
                            voltage_msg = "LOW BATT WARNING"
                        elif voltage <= min_voltage:
                            voltage_msg = "ULTRA LOW BATT!!!"
                        elif voltage >= max_voltage:
                            voltage_msg = "VOLTAGE TOO HIGH"

                        log_addstr(screen, 8, 0, "Battery Voltage: {:2.2f}V".format(board.ANALOG['voltage']))
                        screen.clrtoeol()
                        log_addstr(screen, 8, 24, voltage_msg, curses.A_BOLD + curses.A_BLINK)
                        screen.clrtoeol()

                    elif next_msg == 'MSP_STATUS_EX':
                        ARMED = board.bit_check(board.CONFIG['mode'],0)
                        log_addstr(screen, 5, 0, "ARMED: {}".format(ARMED), curses.A_BOLD)
                        screen.clrtoeol()

                        log_addstr(screen, 5, 50, "armingDisableFlags: {}".format(board.process_armingDisableFlags(board.CONFIG['armingDisableFlags'])))
                        screen.clrtoeol()

                        log_addstr(screen, 6, 0, "cpuload: {}".format(board.CONFIG['cpuload']))
                        screen.clrtoeol()
                        log_addstr(screen, 6, 50, "cycleTime: {}".format(board.CONFIG['cycleTime']))
                        screen.clrtoeol()

                        log_addstr(screen, 7, 0, "mode: {}".format(board.CONFIG['mode']))
                        screen.clrtoeol()

                        log_addstr(screen, 7, 50, "Flight Mode: {}".format(board.process_mode(board.CONFIG['mode'])))
                        screen.clrtoeol()


                    elif next_msg == 'MSP_MOTOR':
                        log_addstr(screen, 9, 0, "Motor Values: {}".format(board.MOTOR_DATA))
                        screen.clrtoeol()
                        
                    elif next_msg == 'MSP_ATTITUDE':
                        log_addstr(screen, 10, 0, "Attitude: {}".format(board.SENSOR_DATA['kinematics']))
                        screen.clrtoeol()
                        
                    elif next_msg == 'MSP_ALTITUDE':
                        log_addstr(screen, 11, 0, "Altitude: {}".format(board.SENSOR_DATA['altitude']))
                        screen.clrtoeol()

                    elif next_msg == 'MSP_RC':
                        log_addstr(screen, 12, 0, "RC Channels Values: {}".format(board.RC['channels']))
                        screen.clrtoeol()

                    log_addstr(screen, 13, 0, "GUI cycleTime: {0:2.2f}ms (average {1:2.2f}Hz)".format((last_cycleTime)*1000,
                                                                                                1/(sum(average_cycle)/len(average_cycle))))
                    screen.clrtoeol()

                    log_addstr(screen, 3, 0, cursor_msg)
                    screen.clrtoeol()
                    

                end_time = time.time()
                last_cycleTime = end_time-start_time
                if (end_time-start_time)<CTRL_LOOP_TIME:
                    time.sleep(CTRL_LOOP_TIME-(end_time-start_time))
                    
                average_cycle.append(end_time-start_time)
                average_cycle.popleft()

    finally:
        log_addstr(screen, 5, 0, "Disconneced from the FC!")
        screen.clrtoeol()

if __name__ == "__main__":
    run_curses(keyboard_controller)
