RodionSmilovskyi/drone-control-center/(commit log)

2025-07-12 Added sample of client server design
2025-09-15 added drone calibration
2025-11-24 updated sensor check
2025-11-25 Added new sensors support
2025-11-25 Fixed sensor logic
2026-02-08 Added 3d printed parts
    [assembly-BottomStand1.stl, assembly-BottomStand2.stl, assembly-BottomStand3.stl, assembly-BottomStand4.stl, assembly-HorizontalRod.stl, assembly-TopStand.stl, assembly-VerticalRod.stl, assembly.FCStd]
2026-02-08 removed unused parts
    [base-connector.FCStd, base-pipe.FCStd, bottom-connector.FCStd, bottom-sensor-holder.3mf, bottom-sensor-holder.FCStd, connector-plane.FCStd, front-sensor-holder.FCStd, protective-frame.FCStd]
2026-02-09 Updated design
    [assembly-HorizontaRod_short.stl, assembly-HorizontalRod.stl, assembly-HorizontalRod_long.stl, assembly.FCStd]
2026-04-17 Added assembly for drone cage
    [assembly.FCStd]
2026-04-17 Updates from device
2026-04-17 Added sensor test script
2026-04-17 NEw sensor check scrpt
2026-04-17 Updated flow scalar
2026-04-17 FLow scalar 0.18
2026-04-17 flow scalar 0,45
2026-04-17 Flow scalar update back to 0.08
2026-04-17 flow coef set to 0.14
2026-04-18 Removed stalle process
2026-09-27 Switch to service based architecture (#1)
    * Pip tools integration
    * Added GEMINI.md file for project context and instructions
    * Added shared memory manager and tests
    * Dasboard with dummy text
    * Moved to service based architecture
    * Updated real sensor
    * Fixed drone service for pi
    * Updated real sensor output
    * Sensor fix
    * Added more logging
    * Updated drone service to point to pyenv python
    * Updated requirements
    * Sensor and depenmdency fix
    * Updated sensor indent fix
    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
    [2_Pin.STL, PMW3901.FCStd, Raspberry Pi Zero 2 W with Textures.stp, TOF400C.FCStd, ai-case.FCStd, assembly-BottomStand1.stl, assembly-BottomStand2.stl, assembly-BottomStand3.stl]
2026-10-25 Enhance FlightController for 3D Shift Control and PID Tuning
2026-10-25 Refine PID tuning parameters and update sensor readings for improved flight control
2026-10-25 Update PID parameters and hover throttle for improved flight stability
2026-10-25 Revert hover throttle baseline to 1550 PWM and implement ground shift isolation to prevent takeoff spikes
2026-10-25 Refine throttle PID parameters and hover baseline for improved descent authority and flight stability
2026-10-25 Calibrate throttle PID parameters and hover baseline for improved liftoff performance and descent authority
2026-10-26 Implement non-blocking optical flow polling and immediate ToF state commit to prevent altitude blackouts
2026-10-26 Enhance sensor polling architecture with dedicated threads for I2C and SPI to prevent blocking, and increase roll/pitch PID gains for improved flight stability and responsiveness.
2026-10-27 Refine PID parameters and thresholds to enhance flight stability and responsiveness; increase throttle PID gains, adjust roll/pitch PID settings, and improve optical flow handling to prevent overshoo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
2026-10-27 Decouple throttle integral threshold from horizontal airborne gate to fix liftoff deadlock; adjust ground threshold for throttle PID and airborne threshold for Roll/Pitch/Yaw PIDs to enhance takeoff 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
2026-10-28 Refine PID controller parameters and integrate derivative smoothing to enhance flight stability; adjust optical flow polling timeout for improved responsiveness and reduce command slew rate to mitiga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
2026-10-28 Refine roll and pitch PID parameters to enhance responsiveness and prevent integral windup; increase command slew rate for improved braking performance.
2026-10-28 Refine PID parameters for roll and pitch to enhance stability and responsiveness; adjust optical flow smoothing to reduce noise without excessive lag.
2026-10-28 Enhance PID controller with anti-windup feature and refine throttle PID parameters for improved stability and responsiveness; adjust roll and pitch PID settings for better control in confined spaces.
2026-11-01 Implement Cascaded Position to Velocity Control Architecture
2026-11-01 Refine cascaded PID controller parameters and implement bounded, return-aware trim integration to prevent integral windup during high-speed returns; adjust optical flow filtering for improved respons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
2026-11-01 Refine cascaded PID controller parameters for improved stability and responsiveness; adjust optical flow filtering to reduce noise and enhance control during high-speed maneuvers.
2026-11-01 Refine cascaded PID controller parameters for improved stability and responsiveness; implement non-blocking logging to prevent stalls during flight operations and enhance return-aware integral unwind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
2026-11-01 Refine cascaded PID controller parameters for improved performance; enhance optical flow processing with multi-frame stall normalization and physical velocity clamping; adjust integral control logic 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
2026-11-01 Refine cascaded PID controller parameters for improved stability and responsiveness; implement anti-slingshot integral logic to prevent windup during dynamic swings; enhance testing suite with regres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
2026-11-01 Refine cascaded PID controller parameters with phase-lead compensation and acceleration clamping; enhance integral management to prevent windup during dynamic swings; add regression test for D-term a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
2026-11-08 Enhance terminal user interface with indoor maneuver test sequence; update keyboard commands for test control and display current test status in system status panel.
2026-11-08 Refine cascaded PID controller parameters and enhance indoor maneuver test sequence. Updated outer loop position authority to kp_pos=0.50 and max_velocity=0.14 m/s, ensuring improved responsiveness a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
2026-11-08 Enhance cascaded PID controller and indoor maneuver test sequence
2026-11-08 Enhance cascaded PID controller parameters and indoor maneuver test sequence
