RodionSmilovskyi/drone-control-center/(notices)

Notices in the files:
scripts/simpleUI.py:
it under the terms of the GNU General Public License as published by
